siliconspecter/pc-gb-link/source/casings/cjmcu_232h.scad

pcb_width_mm = 30;
pcb_length_mm = 43.5;
pcb_top_clearance_mm = 7;
pcb_bottom_clearance_mm = 2;
pcb_support_length_mm = 5.5;
pcb_support_inset_mm = 0;

include <common.scad>
