siliconspecter/pc-gb-link/(commit log)

2025-11-21 Add casings.
    [cjmcu_232h.scad, common.scad]
2025-11-22 Switch FTDI library.
2025-11-23 Remove untested device.
2025-11-24 Adjust USB size.
    [common.scad]
